cmu-argus-2/Avionics-RWboard/Avionics-RWboard.kicad_pcb

## KiCad design Avionics-RWboard.kicad_pcb (2026-01-21)

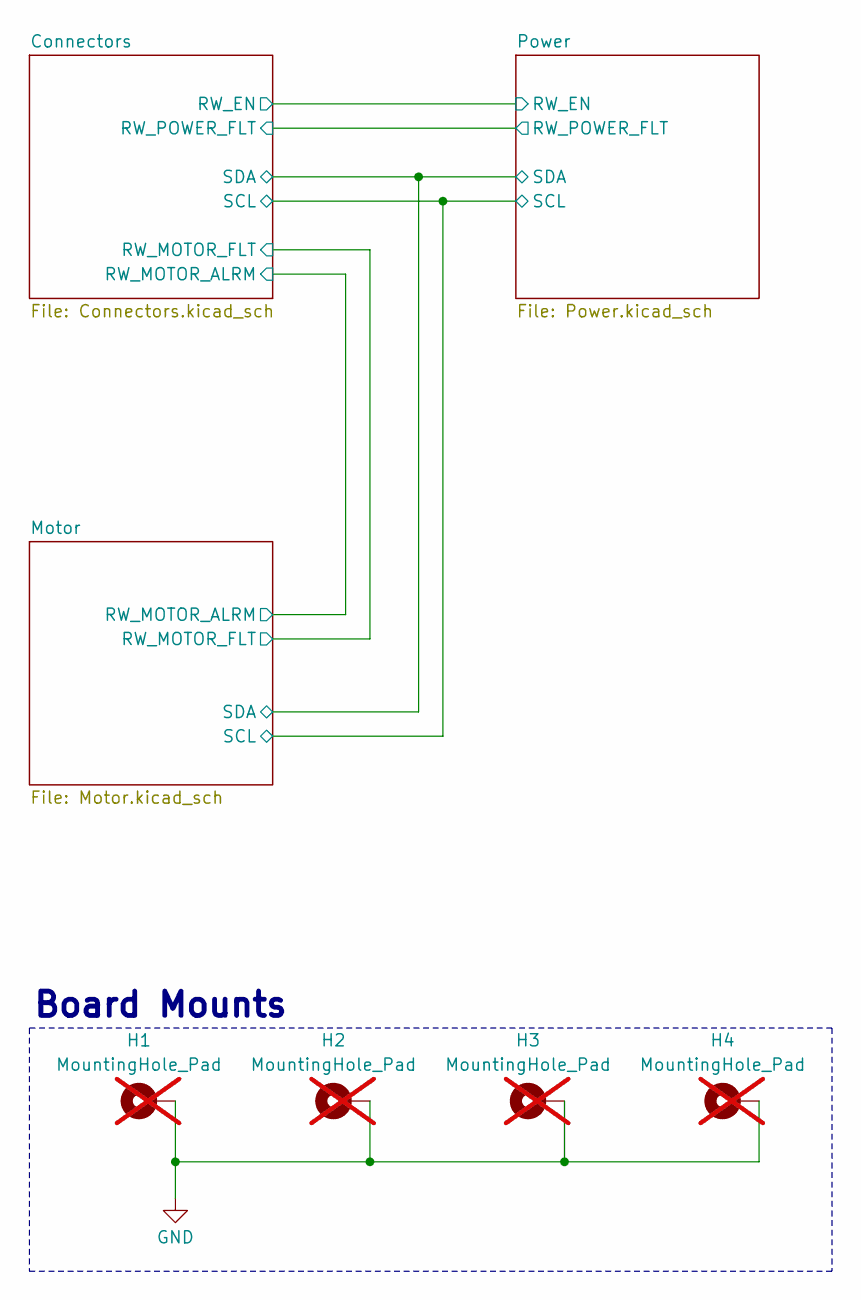
[picture p1: schematic Avionics-RWboard.kicad_sch, Argus Reaction Wheel]

Parts:
H1, H2, H3, H4: MountingHole_Pad; MountingHole_3.2mm_M3_Pad_Via; not fitted

Connections:
GND: H1.1, H2.1, H3.1, H4.1; also elsewhere on the board

Notes on the sheet:
Board Mounts

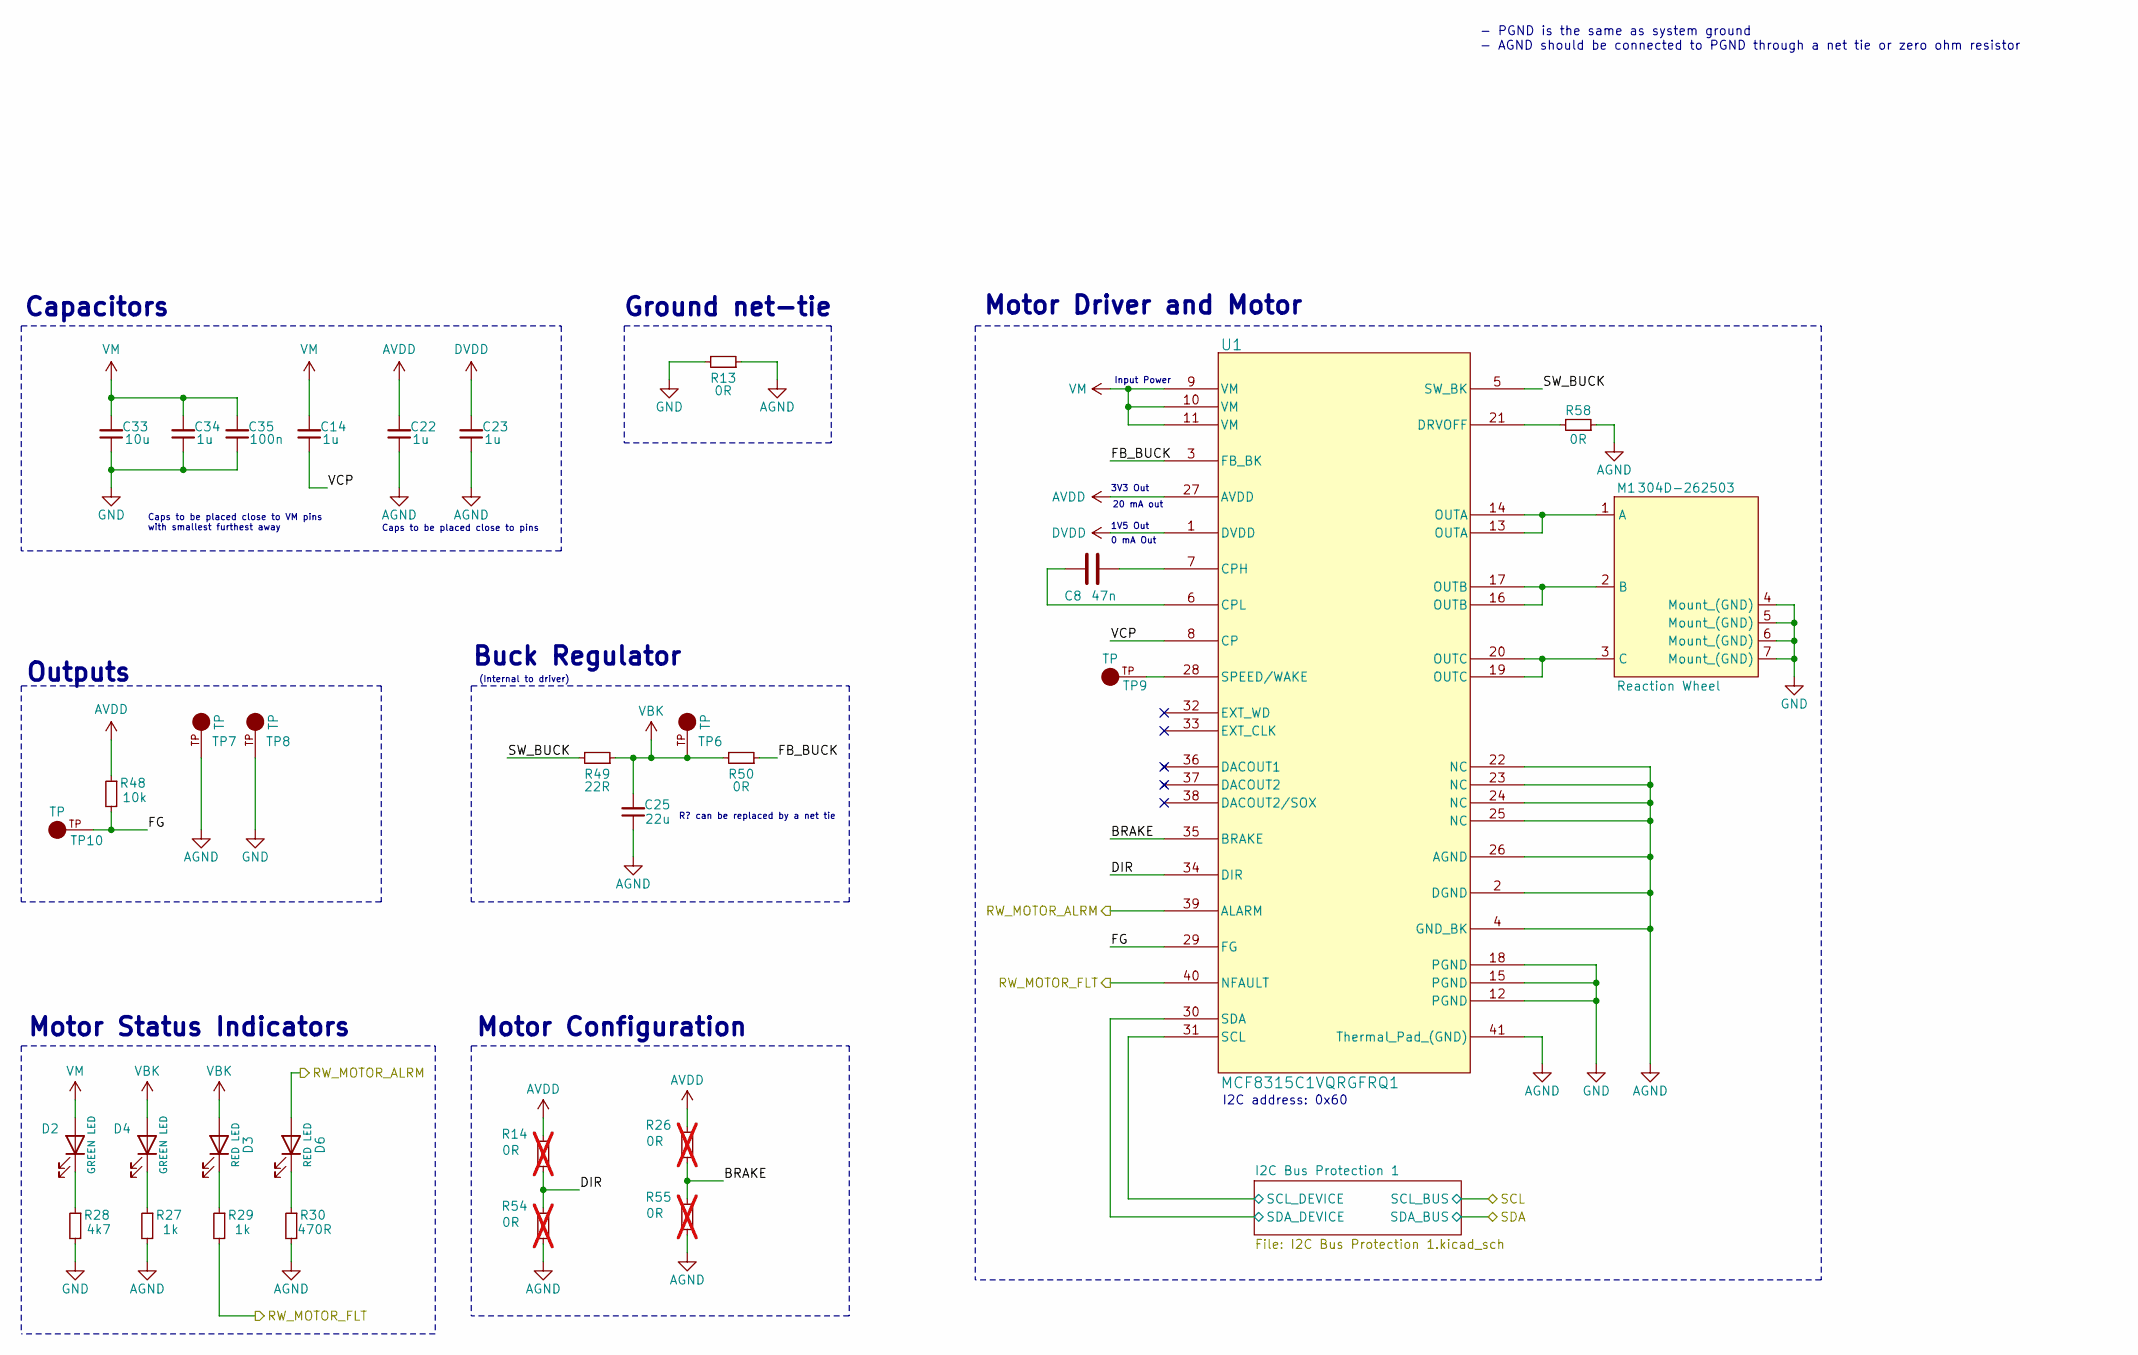
[picture p2: schematic Motor.kicad_sch, Argus Reaction Wheel]

Parts:
C8: 47n; C_0603_1608Metric; Part GCM188R71H473KA55D; Digikey PN 490-4934-1-ND
C14, C22, C23, C34: 1u; C_0603_1608Metric; Part CL10B105KA8NNNC; Digikey PN 1276-1184-1-ND
C25: 22u; C_0603_1608Metric; MPN CL10A226MP8NUNE; Digikey PN 1276-1274-1-ND
C33: 10u; C_1206_3216Metric_Pad1.33x1.80mm_HandSolder; Part CL31B106KAHNNNE; Digikey PN 1276-1804-1-ND
C35: 100n; C_0402_1005Metric_Pad0.74x0.62mm_HandSolder; Part C0402C103K3RACTU; Digikey PN 399-C0402C103K3RACTUCT-ND
D2, D4: GREEN LED; LED_0603_1608Metric; Manufacturer_Part_Number LTST-C190KGKT; Digikey PN 1830-1064-1-ND
D3, D6: RED LED; LED_0603_1608Metric; Manufacturer_Part_Number LTST-C190KRKT; Digikey PN 1830-1065-1-ND
M1: 304D-262503; Reaction_Wheel; MPN 304D-262503; Digikey PN 4827-304D-262503CT-ND
R13, R50: 0R; R_0805_2012Metric_Pad1.20x1.40mm_HandSolder; MPN RC0805JR-070RL; Digikey PN 311-0.0ARCT-ND
R14, R26, R54, R55: 0R; R_0402_1005Metric_Pad0.72x0.64mm_HandSolder; MPN RC0402JR-070RL; Digikey PN 311-0.0JRCT-ND; not fitted
R27, R29: 1k; R_0603_1608Metric; MPN RC0603FR-071KL; Digikey PN 311-1.00KHRCT-ND
R28: 4k7; R_0603_1608Metric; MPN RC0603FR-074K7L; Digikey PN 311-4.70KHRCT-ND
R30: 470R; R_0603_1608Metric; MPN RC0603FR-13470RL; Digikey PN 13-RC0603FR-13470RLCT-ND
R48: 10k; R_0603_1608Metric; MPN RC0603FR-0710KL; Digikey PN 311-10.0KHRCT-ND
R49: 22R; R_2512_6332Metric_Pad1.40x3.35mm_HandSolder; Part CRCW251222R0FKEGHP; Digikey PN 541-CRCW251222R0FKEGHPCT-ND
R58: 0R; R_0402_1005Metric_Pad0.72x0.64mm_HandSolder; MPN RC0402JR-070RL; Digikey PN 311-0.0JRCT-ND
TP6, TP7, TP8, TP9, TP10: TP; KEYSTONE_5001; MPN 5001; Digikey PN 36-5001-ND
U1: MCF8315C1VQRGFRQ1; VQFN40_RGF_TEX; MPN MCF8315C1VQRGFRQ1; Digikey PN 296-MCF8315C1VQRGFRQ1CT-ND

Connections:
/Connectors/RW_MOTOR_ALRM: D6.2 (A), U1.39 (ALARM); also elsewhere on the board
/Connectors/RW_MOTOR_FLT: R29.2, U1.40 (NFAULT); also elsewhere on the board
/Motor/BRAKE: R26.1, R55.2, U1.35 (BRAKE)
/Motor/DIR: R14.1, R54.2, U1.34 (DIR)
/Motor/FB_BUCK: R50.1, U1.3 (FB_BK)
/Motor/FG: R48.2, TP10.TP, U1.29 (FG)
/Motor/I2C Bus Protection 1/SCL_DEVICE: U1.31 (SCL); also elsewhere on the board
/Motor/I2C Bus Protection 1/SDA_DEVICE: U1.30 (SDA); also elsewhere on the board
/Motor/SW_BUCK: R49.2, U1.5 (SW_BK)
/Motor/VCP: C14.1, U1.8 (CP)
AGND: C22.1, C23.1, C25.1, R13.1, R27.2, R30.2, R54.1, R55.1, R58.1, TP7.TP, U1.2 (DGND), U1.4 (GND_BK), U1.22 (NC), U1.23 (NC), U1.24 (NC), U1.25 (NC), U1.26 (AGND), U1.41 (Thermal_Pad_(GND))
AVDD: C22.2, R14.2, R26.2, R48.1, U1.27 (AVDD)
DVDD: C23.2, U1.1 (DVDD)
GND: C33.1, C34.1, C35.1, M1.4 (Mount_(GND)), M1.5 (Mount_(GND)), M1.6 (Mount_(GND)), M1.7 (Mount_(GND)), R13.2, R28.2, TP8.TP, U1.12 (PGND), U1.15 (PGND), U1.18 (PGND); also elsewhere on the board
unnamed: D2.1 (K), R28.1
unnamed: D3.1 (K), R29.1
unnamed: D4.1 (K), R27.1
unnamed: D6.1 (K), R30.1
unnamed: M1.1 (A), U1.13 (OUTA), U1.14 (OUTA)
unnamed: M1.2 (B), U1.16 (OUTB), U1.17 (OUTB)
unnamed: M1.3 (C), U1.19 (OUTC), U1.20 (OUTC)
unnamed: C8.1, U1.7 (CPH)
unnamed: C8.2, U1.6 (CPL)
unnamed: R58.2, U1.21 (DRVOFF)
unnamed: TP9.TP, U1.28 (SPEED/WAKE)
VBK: C25.2, D3.2 (A), D4.2 (A), R49.1, R50.2, TP6.TP
VM: C14.2, C33.2, C34.2, C35.2, D2.2 (A), U1.9 (VM), U1.10 (VM), U1.11 (VM); also elsewhere on the board

Notes on the sheet:
20 mA out
3V3 Out
Caps to be placed close to pins
Buck Regulator
0 mA Out
R? can be replaced by a net tie
Input Power
Motor Status Indicators
I2C address: 0x60
Motor Driver and Motor
Caps to be placed close to VM pins with smallest furthest away
Ground net-tie
Outputs
1V5 Out
- PGND is the same as system ground - AGND should be connected to PGND through a net tie or zero ohm resistor
Motor Configuration
(Internal to driver)
Capacitors

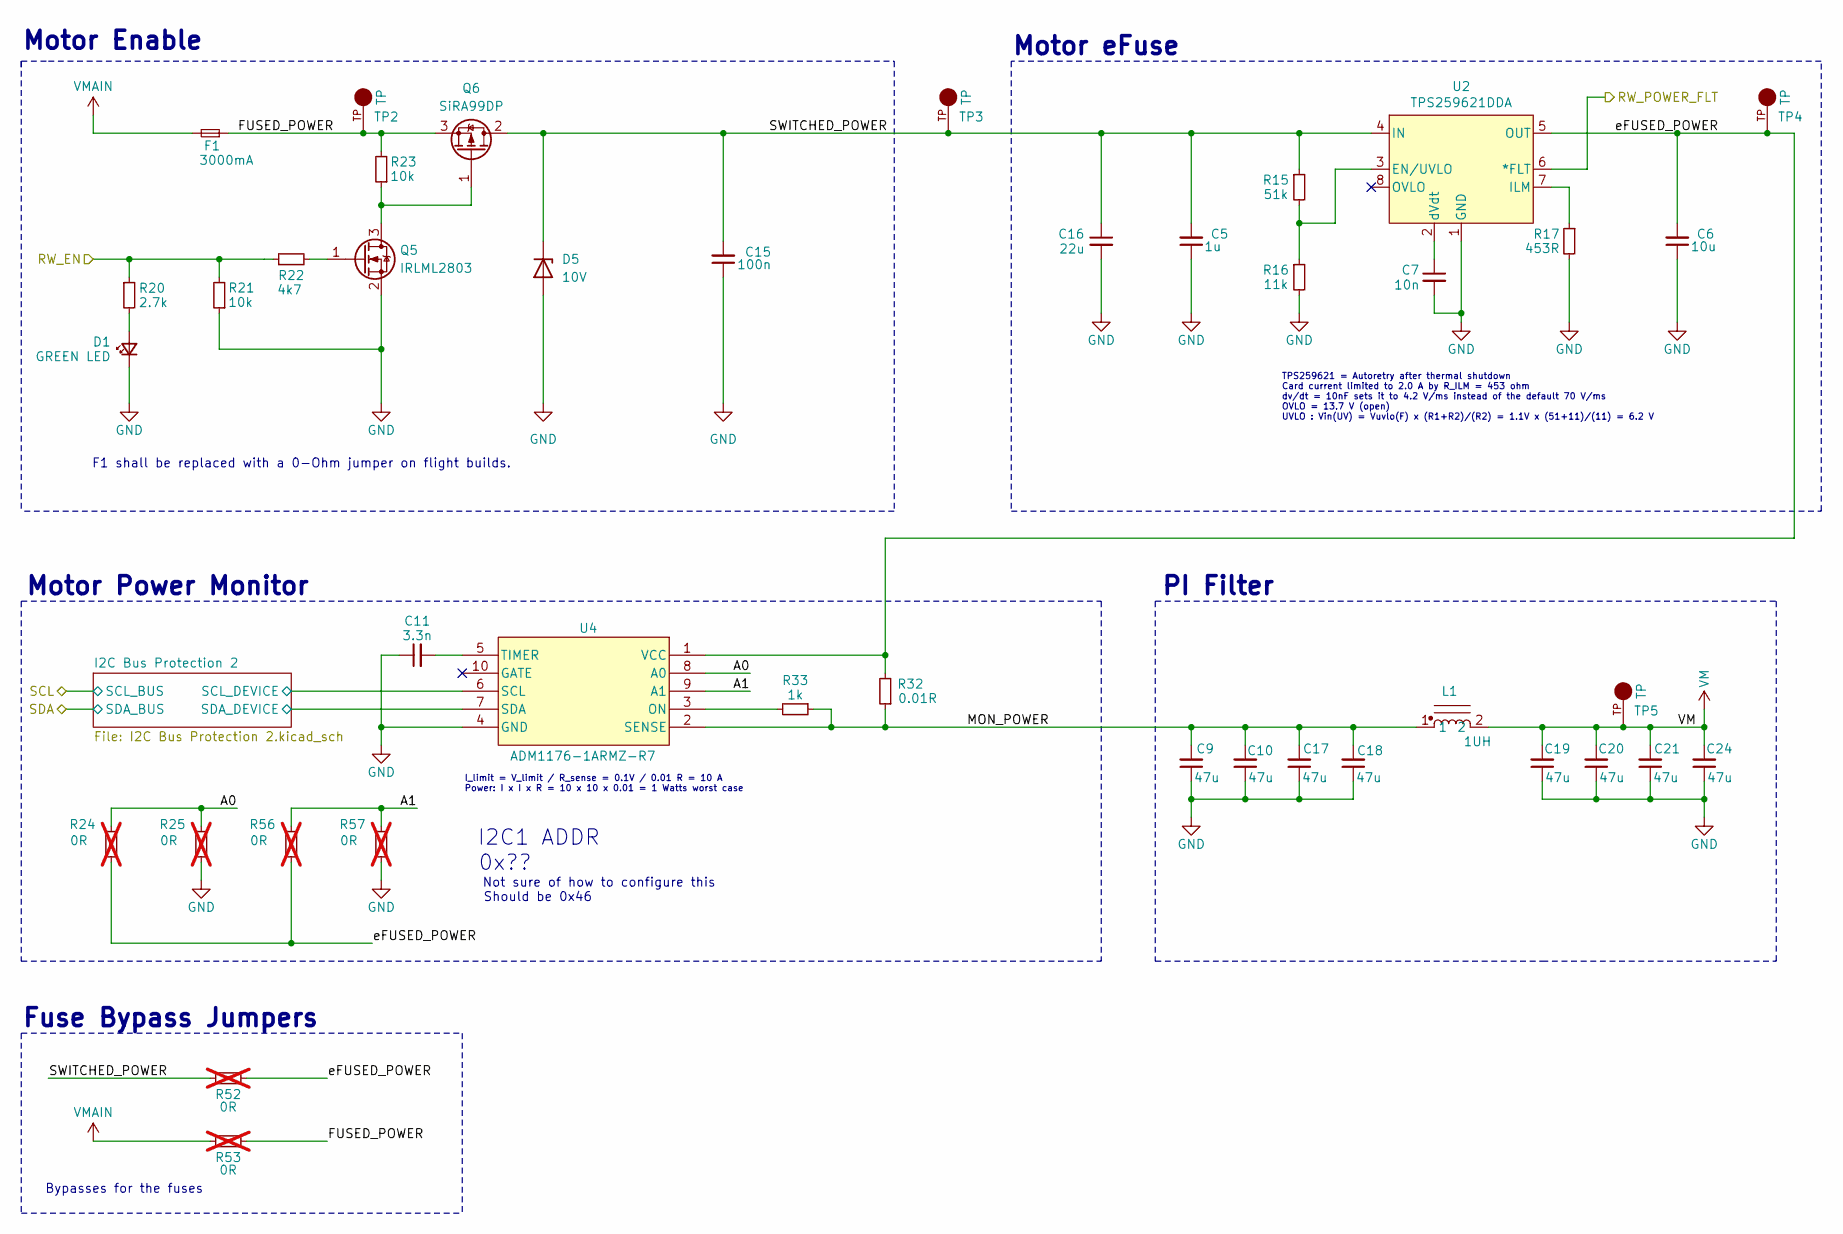
[picture p3: schematic Power.kicad_sch, Argus Reaction Wheel]

Parts:
C5: 1u; C_0603_1608Metric; Part CL10B105KA8NNNC; Digikey PN 1276-1184-1-ND
C6: 10u; C_1206_3216Metric_Pad1.33x1.80mm_HandSolder; Part CL31B106KAHNNNE; Digikey PN 1276-1804-1-ND
C7: 10n; C_0603_1608Metric; MPN CL10B103KO8WPNC; Digikey PN 490-4934-1-ND
C9, C10, C17, C18, C19, C20, C21, C24: 47u; C_1206_3216Metric_Pad1.33x1.80mm_HandSolder; Part C3216X5R1E476M160AC; Digikey PN 445-8047-1-ND
C11: 3.3n; C_0603_1608Metric; Part C0603C332K4REC7411; Digikey PN 399-C0603C332K4REC7411CT-ND
C15: 100n; C_0402_1005Metric_Pad0.74x0.62mm_HandSolder; Part C0402C103K3RACTU; Digikey PN 399-C0402C103K3RACTUCT-ND
C16: 22u; C_1210_3225Metric_Pad1.33x2.70mm_HandSolder; MPN GCM32EC71E226KE36K; Digikey PN 490-GCM32EC71E226KE36KCT-ND
D1: GREEN LED; LED_0603_1608Metric; MPN IN-S63AT5A; Digikey PN 1830-1064-1-ND
D5: 10V; Nexperia_DSN1608-2_1.6x0.8mm; MPN PTVS10VZ1USKYL; Digikey PN 1727-2744-1-ND
F1: 3000mA; Fuse_0603_1608Metric; Part SF-0603S300-2; Digikey PN SF-0603S300-2CT-ND
L1: 1UH; HCM1A1104V2; Part HCM1A1104V2-1R0-R; Digikey PN 283-HCM1A1104V2-1R0-RCT-ND
Q5: IRLML2803; SOT-23; MPN IRLML2803TRPBF; Digikey PN IRLML2803PBFCT-ND
Q6: SiRA99DP; PowerPAK SO-8; MPN SIRA99DP-T1-GE3; Digikey PN SIRA99DP-T1-GE3CT-ND
R15: 51k; R_0603_1608Metric; MPN RC0603FR-0751KL; Digikey PN 311-51.0KHRCT-ND
R16: 11k; R_0603_1608Metric; MPN RC0603FR-0711KL; Digikey PN 311-11.0KHRCT-ND
R17: 453R; R_0603_1608Metric; MPN RC0603FR-07453RL; Digikey PN 311-453HRCT-ND
R20: 2.7k; R_0603_1608Metric; MPN CRGCQ0603F2K7; Digikey PN A129693CT-ND
R21, R23: 10k; R_0603_1608Metric; MPN RC0603FR-0710KL; Digikey PN 311-10.0KHRCT-ND
R22: 4k7; R_0603_1608Metric; MPN RC0603FR-074K7L; Digikey PN 311-4.70KHRCT-ND
R24, R25, R56, R57: 0R; R_0402_1005Metric_Pad0.72x0.64mm_HandSolder; MPN RC0402JR-070RL; Digikey PN 311-0.0JRCT-ND; not fitted
R32: 0.01R; R_0805_2012Metric_Pad1.20x1.40mm_HandSolder; Part ERJ-8BWFR010V; Digikey PN P.010AUCT-ND
R33: 1k; R_0603_1608Metric; MPN RC0603FR-071KL; Digikey PN 311-1.00KHRCT-ND
R52, R53: 0R; R_2512_6332Metric_Pad1.40x3.35mm_HandSolder; Part RC2512FK-070RL; Digikey PN 13-RC2512FK-070RLCT-ND; not fitted
TP2, TP3, TP4, TP5: TP; KEYSTONE_5001; MPN 5001; Digikey PN 36-5001-ND
U2: TPS259621DDA; Texas_R-PDSO-G8_EP2.95x4.9mm_Mask2.4x3.1mm_ThermalVias; MPN TPS259620DDAT; Digikey PN 296-TPS259621DDARCT-ND
U4: ADM1176-1ARMZ-R7; MSOP-10_3x3mm_P0.5mm; Manufacturer_Part_Number ADM1176-1ARMZ-R7; Digikey PN 505-ADM1176-1ARMZ-R7CT-ND

Connections:
/Connectors/RW_EN: R20.1, R21.2, R22.1; also elsewhere on the board
/Connectors/RW_POWER_FLT: U2.6 (*FLT); also elsewhere on the board
/Power/A0: R24.2, R25.2, U4.8 (A0)
/Power/A1: R56.2, R57.2, U4.9 (A1)
/Power/FUSED_POWER: F1.1, Q6.3 (S), R23.2, R53.1, TP2.TP
/Power/I2C Bus Protection 2/SCL_DEVICE: U4.6 (SCL); also elsewhere on the board
/Power/I2C Bus Protection 2/SDA_DEVICE: U4.7 (SDA); also elsewhere on the board
/Power/MON_POWER: C9.2, C10.2, C17.2, C18.2, L1.1, R32.1, R33.1, U4.2 (SENSE)
/Power/SWITCHED_POWER: C5.2, C15.2, C16.1, D5.1 (K), Q6.2 (D), R15.1, R52.2, TP3.TP, U2.4 (IN)
/Power/eFUSED_POWER: C6.2, R24.1, R32.2, R52.1, R56.1, TP4.TP, U2.5 (OUT), U4.1 (VCC)
GND: C5.1, C6.1, C7.2, C9.1, C10.1, C11.1, C15.1, C16.2, C17.1, C18.1, C19.1, C20.1, C21.1, C24.1, D1.1 (K), D5.2 (A), Q5.2 (S), R16.2, R17.2, R21.1, R25.1, R57.1, U2.1 (GND), U2.9 (GND), U4.4 (GND); also elsewhere on the board
unnamed: D1.2 (A), R20.2
unnamed: Q5.3 (D), Q6.1 (G), R23.1
unnamed: Q5.1 (G), R22.2
unnamed: R15.2, R16.1, U2.3 (EN/UVLO)
unnamed: R17.1, U2.7 (ILM)
unnamed: C7.1, U2.2 (dVdt)
unnamed: R33.2, U4.3 (ON)
unnamed: C11.2, U4.5 (TIMER)
VM: C19.2, C20.2, C21.2, C24.2, L1.2, TP5.TP; also elsewhere on the board
VMAIN: F1.2, R53.2; also elsewhere on the board

Notes on the sheet:
Not sure of how to configure this
I2C1 ADDR
0x??
Motor Enable
F1 shall be replaced with a 0-Ohm jumper on flight builds.
I_limit = V_limit / R_sense = 0.1V / 0.01 R = 10 A Power: I x I x R = 10 x 10 x 0.01 = 1 Watts worst case
Motor Power Monitor
TPS259621 = Autoretry after thermal shutdown Card current limited to 2.0 A by R_ILM = 453 ohm dv/dt = 10nF sets it to 4.2 V/ms instead of the default 70 V/ms OVLO = 13.7 V (open) UVLO : Vin(UV) = Vuvlo(F) x (R1+R2)/(R2) = 1.1V x (51+11)/(11) = 6.2 V
Fuse Bypass Jumpers
Should be 0x46
PI Filter
Bypasses for the fuses
Motor eFuse

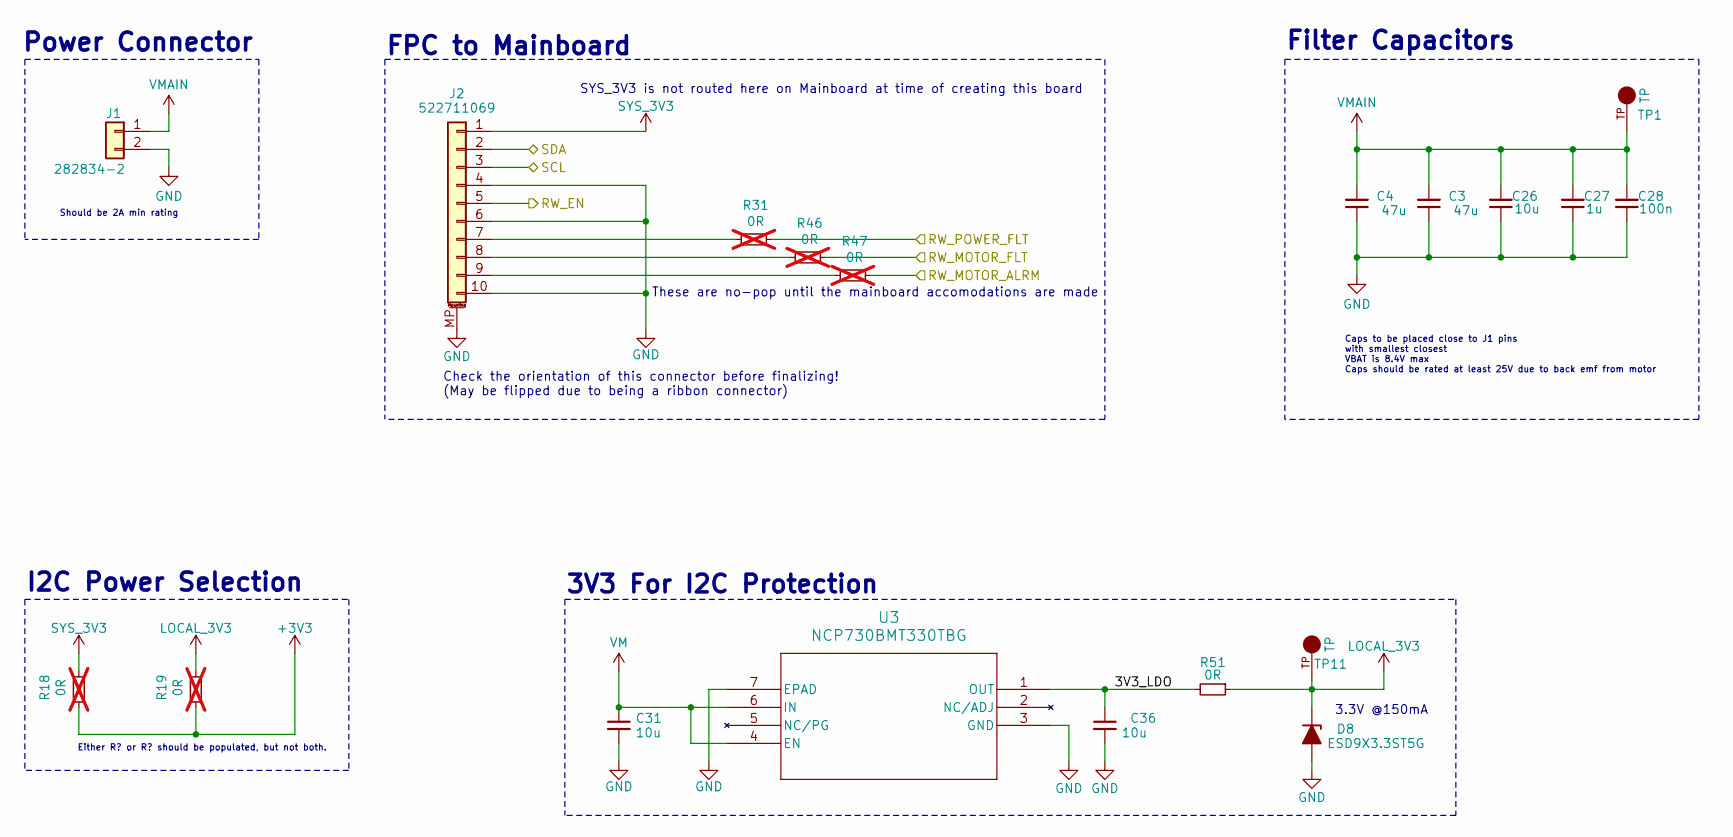
[picture p4: schematic Connectors.kicad_sch, Argus Reaction Wheel]

Parts:
C3, C4: 47u; C_1206_3216Metric_Pad1.33x1.80mm_HandSolder; Part C3216X5R1E476M160AC; Digikey PN 445-8047-1-ND
C26: 10u; C_1206_3216Metric_Pad1.33x1.80mm_HandSolder; Part CL31B106KAHNNNE; Digikey PN 1276-1804-1-ND
C27: 1u; C_0603_1608Metric; Part CL10B105KA8NNNC; Digikey PN 1276-1184-1-ND
C28: 100n; C_0402_1005Metric_Pad0.74x0.62mm_HandSolder; Part C0402C103K3RACTU; Digikey PN 399-C0402C103K3RACTUCT-ND
C31, C36: 10u; C_0603_1608Metric; MPN C1608X5R1E106M080AC; Digikey PN 445-9015-1-ND
D8: ESD9X3.3ST5G; D_SOD-923; MPN ESD9X5.0ST5G; Digikey PN ESD9X3.3ST5GOSCT-ND
J1: 282834-2; TE_282834-2; MPN 282834-2; Digikey PN A98333-ND
J2: 522711069; Molex_200528-0100_1x10-1MP_P1.00mm_Horizontal; MPN 200528-0100; Digikey PN 900-2005280100CT-ND
R18, R19, R31, R46, R47: 0R; R_0402_1005Metric_Pad0.72x0.64mm_HandSolder; MPN RC0402JR-070RL; Digikey PN 311-0.0JRCT-ND; not fitted
R51: 0R; R_0603_1608Metric; MPN CR0603-J/-000ELF; Digikey PN CR0603-J/-000ELFCT-ND
TP1, TP11: TP; KEYSTONE_5001; MPN 5001; Digikey PN 36-5001-ND
U3: NCP730BMT330TBG; WDFN6-2x2_511BR_OSI; MPN NCP730BMT330TBG; Digikey PN 488-NCP730BMT330TBGCT-ND

Connections:
+3V3: R18.1, R19.1; also elsewhere on the board
/Connectors/3V3_LDO: C36.1, R51.2, U3.1 (OUT)
/Connectors/RW_EN: J2.5; also elsewhere on the board
/Connectors/RW_MOTOR_ALRM: R47.2; also elsewhere on the board
/Connectors/RW_MOTOR_FLT: R46.2; also elsewhere on the board
/Connectors/RW_POWER_FLT: R31.2; also elsewhere on the board
/Connectors/SCL: J2.3; also elsewhere on the board
/Connectors/SDA: J2.2; also elsewhere on the board
GND: C3.1, C4.1, C26.1, C27.1, C28.1, C31.2, C36.2, D8.2 (A), J1.2, J2.4, J2.6, J2.10, J2.MP (MountPin), U3.3 (GND), U3.7 (EPAD); also elsewhere on the board
LOCAL_3V3: D8.1 (K), R19.2, R51.1, TP11.TP
unnamed: J2.7, R31.1
unnamed: J2.8, R46.1
unnamed: J2.9, R47.1
SYS_3V3: J2.1, R18.2
VM: C31.1, U3.4 (EN), U3.6 (IN); also elsewhere on the board
VMAIN: C3.2, C4.2, C26.2, C27.2, C28.2, J1.1, TP1.TP; also elsewhere on the board

Notes on the sheet:
Filter Capacitors
Caps to be placed close to J1 pins with smallest closest VBAT is 8.4V max Caps should be rated at least 25V due to back emf from motor
3.3V @150mA
These are no-pop until the mainboard accomodations are made
Check the orientation of this connector before finalizing! (May be flipped due to being a ribbon connector)
Either R? or R? should be populated, but not both.
3V3 For I2C Protection
Should be 2A min rating
I2C Power Selection
SYS_3V3 is not routed here on Mainboard at time of creating this board
Power Connector
FPC to Mainboard

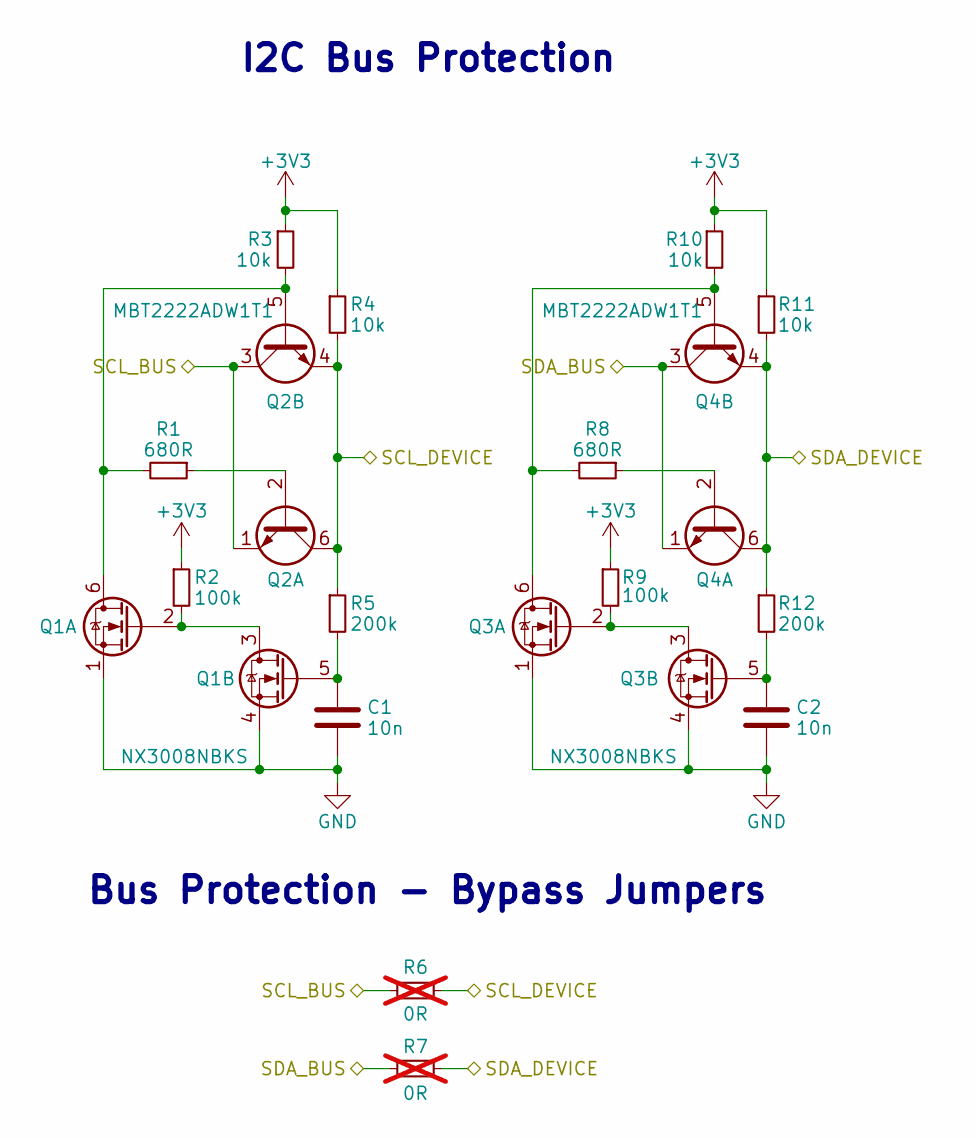
[picture p5: schematic I2C Bus Protection 1.kicad_sch, Argus Reaction Wheel]

Parts:
C1, C2: 10n; C_0603_1608Metric; Part CL10B103KO8WPNC; Digikey PN 490-4934-1-ND
Q1, Q3: NX3008NBKS; SOT-363_SC-70-6; Manufacturer_Part_Number NX3008NBKS; Digikey PN 1727-1221-1-ND
Q2, Q4: MBT2222ADW1T1; SOT-363_SC-70-6; Manufacturer_Part_Number MBT2222ADW1T1G; Digikey PN MBT2222ADW1T1GOSCT-ND
R1, R8: 680R; R_0603_1608Metric; MPN RC0603FR-07680RL; Digikey PN 311-680HRCT-ND
R2, R9: 100k; R_0603_1608Metric; MPN RC0603FR-07100KL; Digikey PN 311-100KHRCT-ND
R3, R4, R10, R11: 10k; R_0603_1608Metric; MPN RC0603FR-0710KL; Digikey PN 311-10.0KHRCT-ND
R5, R12: 200k; R_0603_1608Metric; MPN RC0603FR-07200KL; Digikey PN 311-200KHRCT-ND
R6, R7: 0R; R_0603_1608Metric; MPN CR0603-J/-000ELF; Digikey PN CR0603-J/-000ELFCT-ND; not fitted

Connections:
+3V3: R2.1, R3.1, R4.1, R9.1, R10.1, R11.1; also elsewhere on the board
/Connectors/SCL: Q2.1 (E1), Q2.3 (C2), R6.2; also elsewhere on the board
/Connectors/SDA: Q4.1 (E1), Q4.3 (C2), R7.2; also elsewhere on the board
/Motor/I2C Bus Protection 1/SCL_DEVICE: Q2.4 (E2), Q2.6 (C1), R4.2, R5.1, R6.1; also elsewhere on the board
/Motor/I2C Bus Protection 1/SDA_DEVICE: Q4.4 (E2), Q4.6 (C1), R7.1, R11.2, R12.1; also elsewhere on the board
GND: C1.2, C2.2, Q1.1 (S), Q1.4 (S), Q3.1 (S), Q3.4 (S); also elsewhere on the board
unnamed: Q1.6 (D), Q2.5 (B2), R1.2, R3.2
unnamed: Q1.2 (G), Q1.3 (D), R2.2
unnamed: C1.1, Q1.5 (G), R5.2
unnamed: Q2.2 (B1), R1.1
unnamed: Q3.6 (D), Q4.5 (B2), R8.2, R10.2
unnamed: Q3.2 (G), Q3.3 (D), R9.2
unnamed: C2.1, Q3.5 (G), R12.2
unnamed: Q4.2 (B1), R8.1

Notes on the sheet:
Bus Protection - Bypass Jumpers
I2C Bus Protection

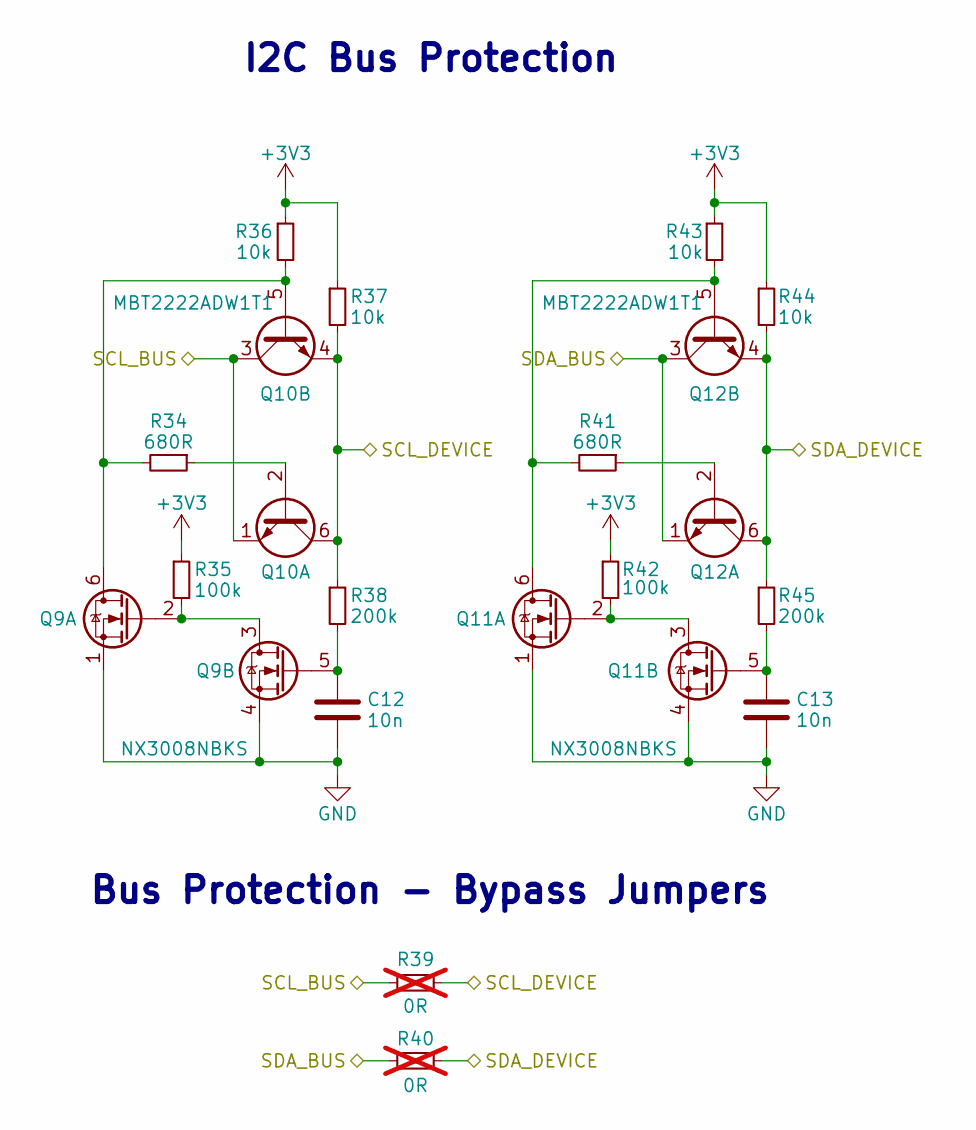
[picture p6: schematic I2C Bus Protection 2.kicad_sch, Argus Reaction Wheel]

Parts:
C12, C13: 10n; C_0603_1608Metric; Part CL10B103KO8WPNC; Digikey PN 490-4934-1-ND
Q9, Q11: NX3008NBKS; SOT-363_SC-70-6; Manufacturer_Part_Number NX3008NBKS; Digikey PN 1727-1221-1-ND
Q10, Q12: MBT2222ADW1T1; SOT-363_SC-70-6; Manufacturer_Part_Number MBT2222ADW1T1G; Digikey PN MBT2222ADW1T1GOSCT-ND
R34, R41: 680R; R_0603_1608Metric; MPN RC0603FR-07680RL; Digikey PN 311-680HRCT-ND
R35, R42: 100k; R_0603_1608Metric; MPN RC0603FR-07100KL; Digikey PN 311-100KHRCT-ND
R36, R37, R43, R44: 10k; R_0603_1608Metric; MPN RC0603FR-0710KL; Digikey PN 311-10.0KHRCT-ND
R38, R45: 200k; R_0603_1608Metric; MPN RC0603FR-07200KL; Digikey PN 311-200KHRCT-ND
R39, R40: 0R; R_0603_1608Metric; MPN CR0603-J/-000ELF; Digikey PN CR0603-J/-000ELFCT-ND; not fitted

Connections:
+3V3: R35.1, R36.1, R37.1, R42.1, R43.1, R44.1; also elsewhere on the board
/Connectors/SCL: Q10.1 (E1), Q10.3 (C2), R39.2; also elsewhere on the board
/Connectors/SDA: Q12.1 (E1), Q12.3 (C2), R40.2; also elsewhere on the board
/Power/I2C Bus Protection 2/SCL_DEVICE: Q10.4 (E2), Q10.6 (C1), R37.2, R38.1, R39.1; also elsewhere on the board
/Power/I2C Bus Protection 2/SDA_DEVICE: Q12.4 (E2), Q12.6 (C1), R40.1, R44.2, R45.1; also elsewhere on the board
GND: C12.2, C13.2, Q9.1 (S), Q9.4 (S), Q11.1 (S), Q11.4 (S); also elsewhere on the board
unnamed: Q9.2 (G), Q9.3 (D), R35.2
unnamed: C12.1, Q9.5 (G), R38.2
unnamed: Q10.2 (B1), R34.1
unnamed: Q9.6 (D), Q10.5 (B2), R34.2, R36.2
unnamed: Q11.6 (D), Q12.5 (B2), R41.2, R43.2
unnamed: Q11.2 (G), Q11.3 (D), R42.2
unnamed: C13.1, Q11.5 (G), R45.2
unnamed: Q12.2 (B1), R41.1

Notes on the sheet:
Bus Protection - Bypass Jumpers
I2C Bus Protection

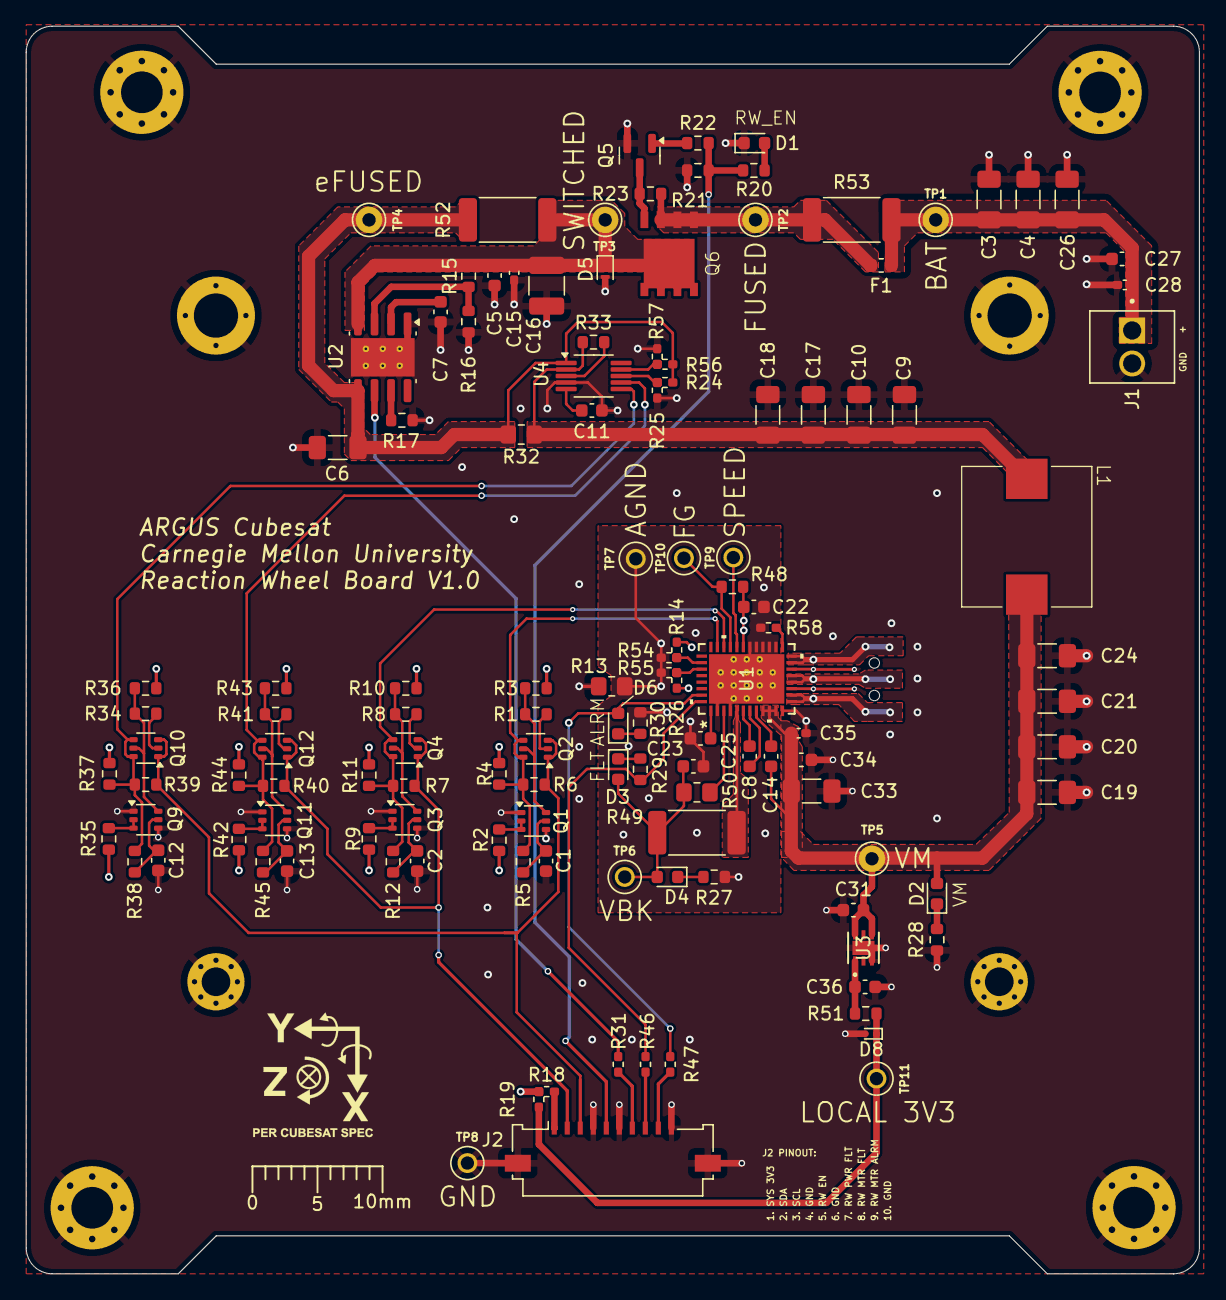
[picture p7: board Avionics-RWboard.kicad_pcb from above]

Board: 4 copper layers, 90.2 x 95.9 mm, 132 parts (1 on the bottom side), 71 nets.
