cmu-argus-2/Avionics-RWboard/(commit log)

2025-03-15 Add schematics. Still need to check power and voltage ratings. Still need to get all the footprints sorted out. Still need to layout board.
    [Avionics-RWboard.kicad_sch, Connectors.kicad_sch, I2C Bus Protection 1.kicad_sch, I2C Bus Protection 2.kicad_sch, Motor.kicad_sch, Power.kicad_sch]
2025-03-15 Checked all power and voltage ratings and corrected where needed. Still need footprints and layout completed.
    [Avionics-RWboard.kicad_pcb, Connectors.kicad_sch, Motor.kicad_sch, Power.kicad_sch]
2025-03-15 Clean notes
    [Power.kicad_sch]
2025-03-15 Start layout, still missing some footprints
    [Avionics-RWboard.kicad_pcb, Avionics-RWboard.kicad_sch]
2025-03-15 Add more test points
    [Connectors.kicad_sch, Motor.kicad_sch, Power.kicad_sch]
2025-03-25 Layout mostly complete
    [Avionics-RWboard.kicad_pcb, Avionics-RWboard.kicad_sch, Connectors.kicad_sch, I2C Bus Protection 1.kicad_sch, I2C Bus Protection 2.kicad_sch, Motor.kicad_sch, Power.kicad_sch]
2025-03-25 Update silkscreen
    [Avionics-RWboard.kicad_pcb]
2025-03-25 Push changes that were not saved on the schematic with last push
    [Motor.kicad_sch]
2025-03-28 Push requested changes - silkscreen, copper width, pi filter
    [Avionics-RWboard.kicad_pcb, Motor.kicad_sch, Power.kicad_sch]
2025-04-09 Add and correct BOM for easy Digikey ordering
    [Avionics-RWboard.kicad_pcb, Avionics-RWboard.kicad_sch, Connectors.kicad_sch, I2C Bus Protection 1.kicad_sch, I2C Bus Protection 2.kicad_sch, Motor.kicad_sch, Power.kicad_sch]
2026-01-21 Local Stash
    [Avionics-RWboard.kicad_pcb, Avionics-RWboard.kicad_sch, Connectors.kicad_sch, I2C Bus Protection 1.kicad_sch, I2C Bus Protection 2.kicad_sch, Motor.kicad_sch, Power.kicad_sch]
