cmu-argus-2/Avionics-RWboard/(notices)

Notices in the files:
parts and their libraries:
License: Apache-2.0
